zbockaj/GarageNotifier-PCB/README.md

# GarageNotifier-PCB
Helium-network device for reporting open/closed status of (garage) door.
