zbockaj/GarageNotifier-PCB/GarageNotifier.kicad_pcb

## KiCad design GarageNotifier.kicad_pcb (2022-08-15)

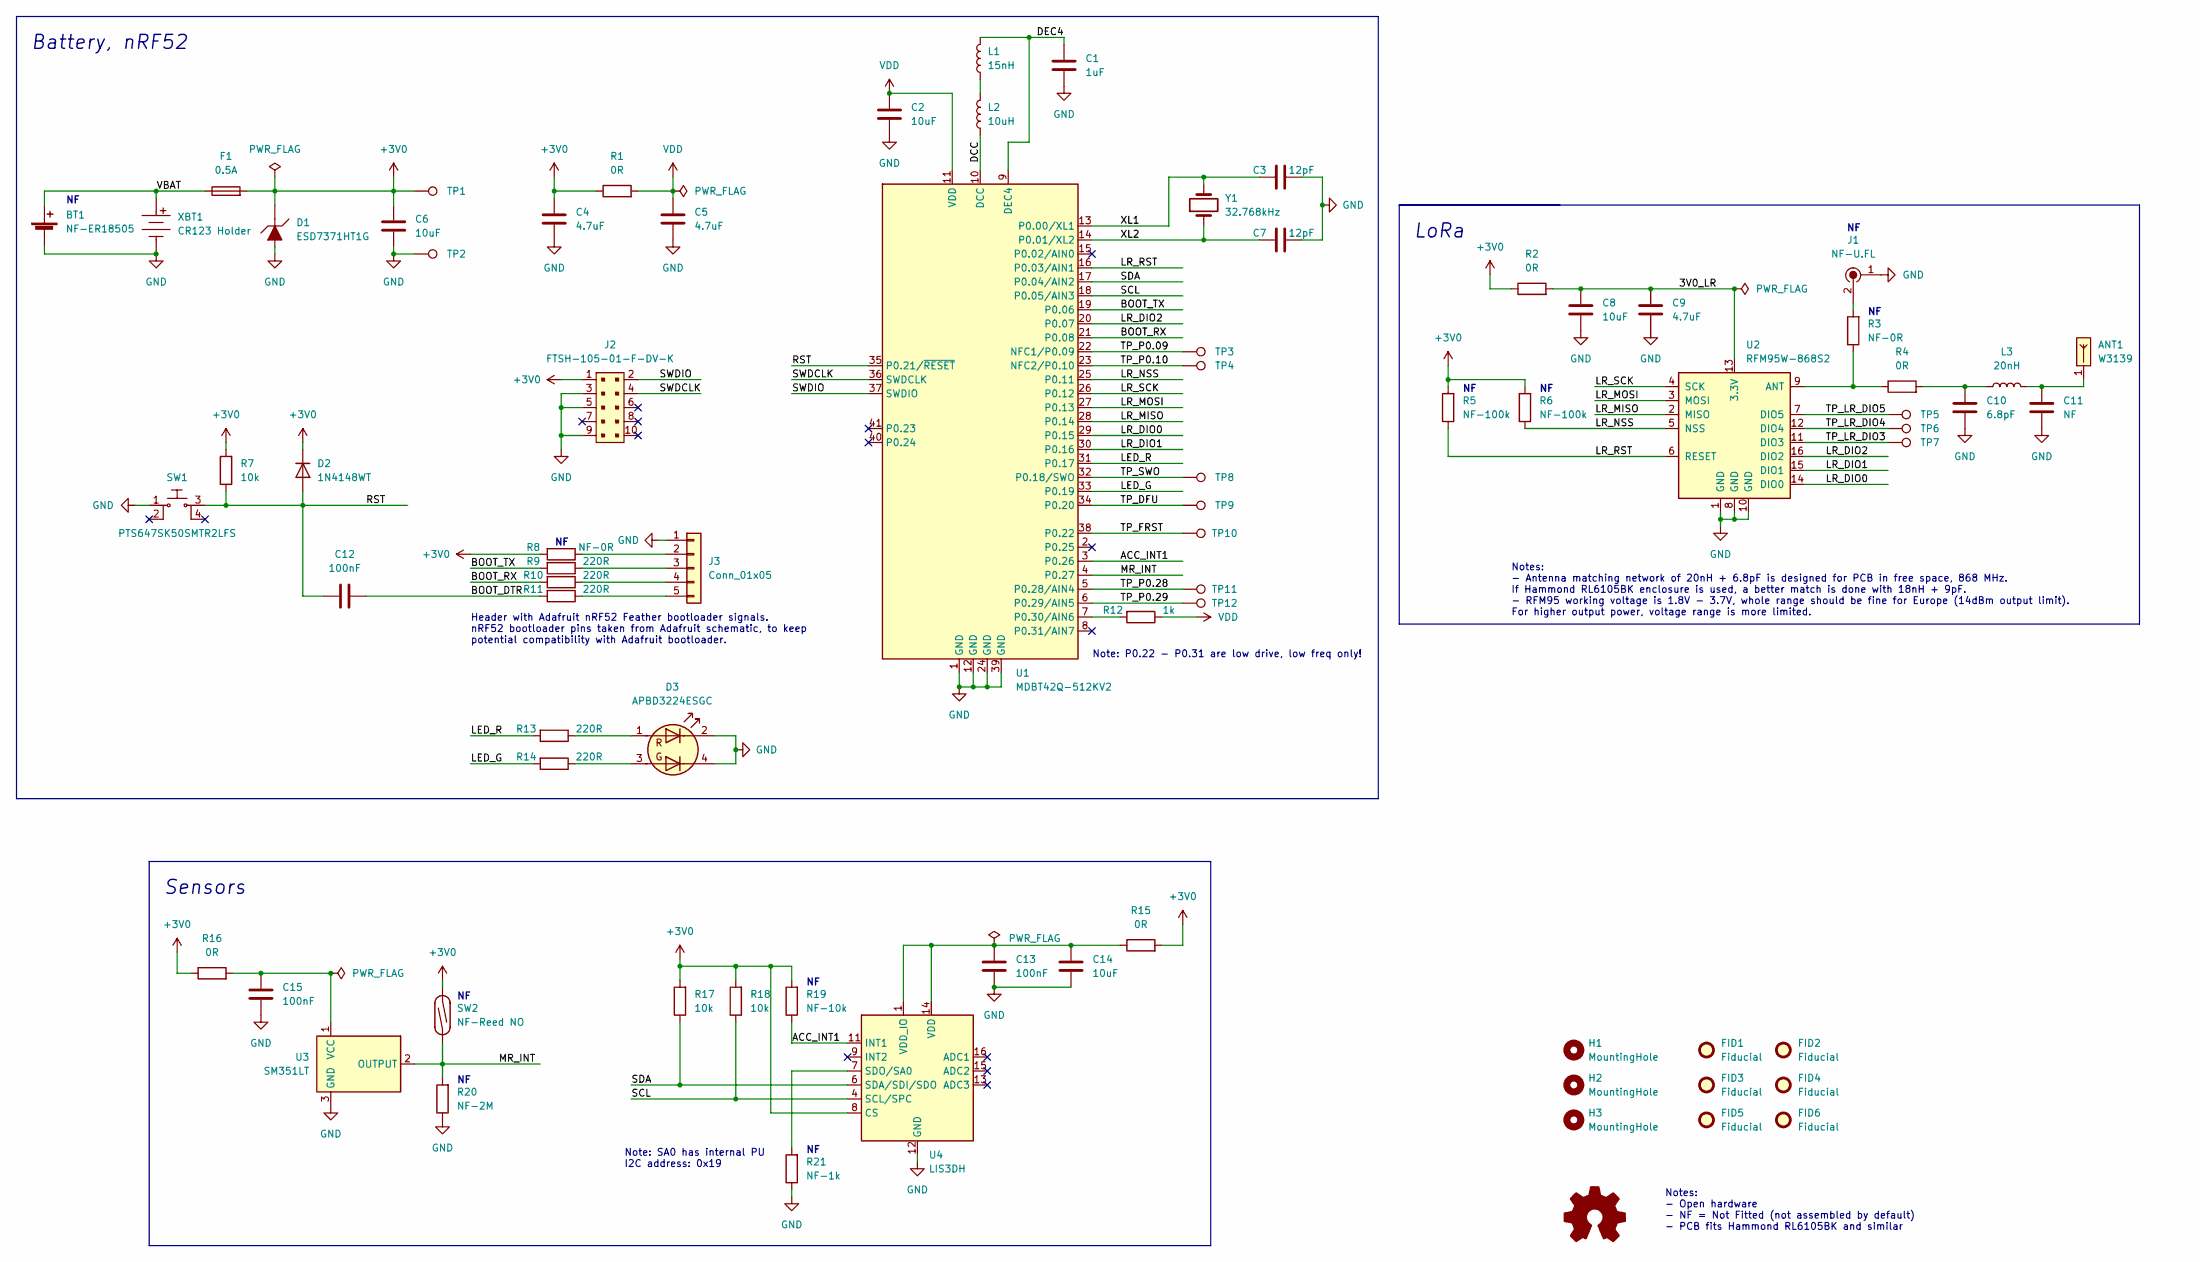
[picture p1: schematic GarageNotifier.kicad_sch]

Parts:
ANT1: W3139; MPN W3139
BT1: NF-ER18505; ER18505; MPN ER18505
C1: 1uF; C_0402_1005Metric
C2, C6, C8, C14: 10uF; C_0603_1608Metric
C3, C7: 12pF; C_0402_1005Metric
C4, C5, C9: 4.7uF; C_0603_1608Metric
C10: 6.8pF; C_0603_1608Metric
C11: NF; C_0603_1608Metric
C12, C13, C15: 100nF; C_0603_1608Metric
D1: ESD7371HT1G; SOD-323; MPN ESD7371HT1G
D2: 1N4148WT; D_SOD-523; MPN 1N4148WT
D3: APBD3224ESGC; LED_Kingbright_APBD3224; MPN APBD3224ESGC-F01
F1: 0.5A; R_0603_1608Metric; MPN 0467.500NRHF
FID1, FID2, FID3, FID4, FID5, FID6: Fiducial; Fiducial_1mm_Mask2mm
H1, H2, H3: MountingHole; MountingHole_2.7mm_M2.5_ISO7380
J1: NF-U.FL; Coax_Conn_U.FL; MPN U.FL-R-SMT-1(10); Digi-Key_PN H11891CT-ND
J2: FTSH-105-01-F-DV-K; PinHeader_2x5_P1.27_SMD; MPN FTSH-105-01-F-DV-K; Digi-Key_PN SAM8796-ND
J3: Conn_01x05; PinHeader_1x05_P2.54mm_Vertical
L1: 15nH; L_0402_1005Metric; MPN LQG15HS15NJ02D
L2: 10uH; L_0603_1608Metric; MPN LQM18FN100M00D
L3: 20nH; L_0603_1608Metric; MPN LQW18AN20NG00D
R1, R2, R4, R15, R16: 0R; R_0603_1608Metric
R3, R8: NF-0R; R_0603_1608Metric
R5, R6: NF-100k; R_0603_1608Metric
R7, R17, R18: 10k; R_0603_1608Metric
R9, R10, R11, R13, R14: 220R; R_0603_1608Metric
R12: 1k; R_0603_1608Metric
R19: NF-10k; R_0603_1608Metric
R20: NF-2M; R_0603_1608Metric
R21: NF-1k; R_0603_1608Metric
SW1: PTS647SK50SMTR2LFS; MPN PTS647SK50SMTR2LFS
SW2: NF-Reed NO; MK15-B-2_Reed; MPN MK15-B-2
TP1, TP2, TP3, TP4, TP5, TP6, TP7, TP8, TP9, TP10, TP11, TP12: TestPoint; TestPoint_Pad_D1.5mm
U1: MDBT42Q-512KV2; MPN MDBT42Q-512KV2
U2: RFM95W-868S2; HOPERF_RFM9XW_SMD; MPN 109990166
U3: SM351LT; SOT-23; MPN SM351LT
U4: LIS3DH; ST_LGA-16_3x3mm; MPN LIS3DHTR
XBT1: CR123 Holder; Keystone_1051; MPN 1051
Y1: 32.768kHz; Crystal_SMD_3215-2Pin_3.2x1.5mm; MPN FC-135 32.7680KA-AC

Connections:
+3V0: C4.1, C6.1, D1.1 (A1), D2.1 (K), F1.2, J2.1, R1.1, R2.1, R5.2, R6.2, R7.2, R8.2, R15.2, R16.1, R17.2, R18.2, R19.2, SW2.2, TP1.1, U4.8 (CS)
/3V0_LR: C8.1, C9.1, R2.2, U2.13 (3.3V)
/ACC_INT1: R19.1, U1.3 (P0.26), U4.11 (INT1)
/BOOT_DTR: C12.1, R11.2
/BOOT_RX: R10.2, U1.21 (P0.08)
/BOOT_TX: R9.2, U1.19 (P0.06)
/DCC: L2.1, U1.10 (DCC)
/DEC4: C1.1, L1.2, U1.9 (DEC4)
/LED_G: R14.2, U1.33 (P0.19)
/LED_R: R13.2, U1.31 (P0.17)
/LR_DIO0: U1.29 (P0.15), U2.14 (DIO0)
/LR_DIO1: U1.30 (P0.16), U2.15 (DIO1)
/LR_DIO2: U1.20 (P0.07), U2.16 (DIO2)
/LR_MISO: U1.28 (P0.14), U2.2 (MISO)
/LR_MOSI: U1.27 (P0.13), U2.3 (MOSI)
/LR_NSS: R6.1, U1.25 (P0.11), U2.5 (NSS)
/LR_RST: R5.1, U1.16 (P0.03/AIN1), U2.6 (RESET)
/LR_SCK: U1.26 (P0.12), U2.4 (SCK)
/MR_INT: R20.2, SW2.1, U1.4 (P0.27), U3.2 (OUTPUT)
/RST: C12.2, D2.2 (A), R7.1, SW1.3, U1.35 (P0.21/~RESET)
/SCL: R18.1, U1.18 (P0.05/AIN3), U4.4 (SCL/SPC)
/SDA: R17.1, U1.17 (P0.04/AIN2), U4.6 (SDA/SDI/SDO)
/SWDCLK: J2.4, U1.36 (SWDCLK)
/SWDIO: J2.2, U1.37 (SWDIO)
/TP_DFU: TP9.1, U1.34 (P0.20)
/TP_FRST: TP10.1, U1.38 (P0.22)
/TP_LR_DIO3: TP7.1, U2.11 (DIO3)
/TP_LR_DIO4: TP6.1, U2.12 (DIO4)
/TP_LR_DIO5: TP5.1, U2.7 (DIO5)
/TP_P0.09: TP3.1, U1.22 (NFC1/P0.09)
/TP_P0.10: TP4.1, U1.23 (NFC2/P0.10)
/TP_P0.28: TP11.1, U1.5 (P0.28/AIN4)
/TP_P0.29: TP12.1, U1.6 (P0.29/AIN5)
/TP_SWO: TP8.1, U1.32 (P0.18/SWO)
/VBAT: BT1.1 (+), F1.1, XBT1.1
/XL1: C3.1, U1.13 (P0.00/XL1), Y1.2
/XL2: C7.1, U1.14 (P0.01/XL2), Y1.1
GND: BT1.2 (-), C1.2, C2.2, C3.2, C4.2, C5.2, C6.2, C7.2, C8.2, C9.2, C10.1, C11.1, C13.2, C14.2, C15.2, D1.2 (A2), D3.2 (K1), D3.4 (K2), J1.1, J2.3, J2.5, J2.9, J3.1, R20.1, R21.1, SW1.1, TP2.1, U1.1 (GND), U1.12 (GND), U1.24 (GND), U1.39 (GND), U2.1 (GND), U2.8 (GND), U2.10 (GND), U3.3 (GND), U4.5 (GND), U4.10 (GND), U4.12 (GND), XBT1.2
unnamed: ANT1.1 (FP), C11.2, L3.2
unnamed: C10.2, L3.1, R4.2
unnamed: C13.1, C14.1, R15.1, U4.1 (VDD_IO), U4.14 (VDD)
unnamed: C15.1, R16.2, U3.1 (VCC)
unnamed: D3.1 (A1), R13.1
unnamed: D3.3 (A2), R14.1
unnamed: J1.2, R3.2
unnamed: J3.2, R8.1
unnamed: J3.3, R9.1
unnamed: J3.4, R10.1
unnamed: J3.5, R11.1
unnamed: L1.1, L2.2
unnamed: R3.1, R4.1, U2.9 (ANT)
unnamed: R12.2, U1.7 (P0.30/AIN6)
unnamed: R21.2, U4.7 (SDO/SA0)
VDD: C2.1, C5.1, R1.2, R12.1, U1.11 (VDD)

Notes on the sheet:
Notes: - Antenna matching network of 20nH + 6.8pF is designed for PCB in free space, 868 MHz. If Hammond RL6105BK enclosure is used, a better match is done with 18nH + 9pF. - RFM95 working voltage is 1.8V - 3.7V, whole range should be fine for Europe (14dBm output limit). For higher output power, v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
Note: P0.22 - P0.31 are low drive, low freq only!
Notes: - Open hardware - NF = Not Fitted (not assembled by default) - PCB fits Hammond RL6105BK and similar
Sensors
Battery, nRF52
Header with Adafruit nRF52 Feather bootloader signals. nRF52 bootloader pins taken from Adafruit schematic, to keep potential compatibility with Adafruit bootloader.
Note: SA0 has internal PU I2C address: 0x19
LoRa

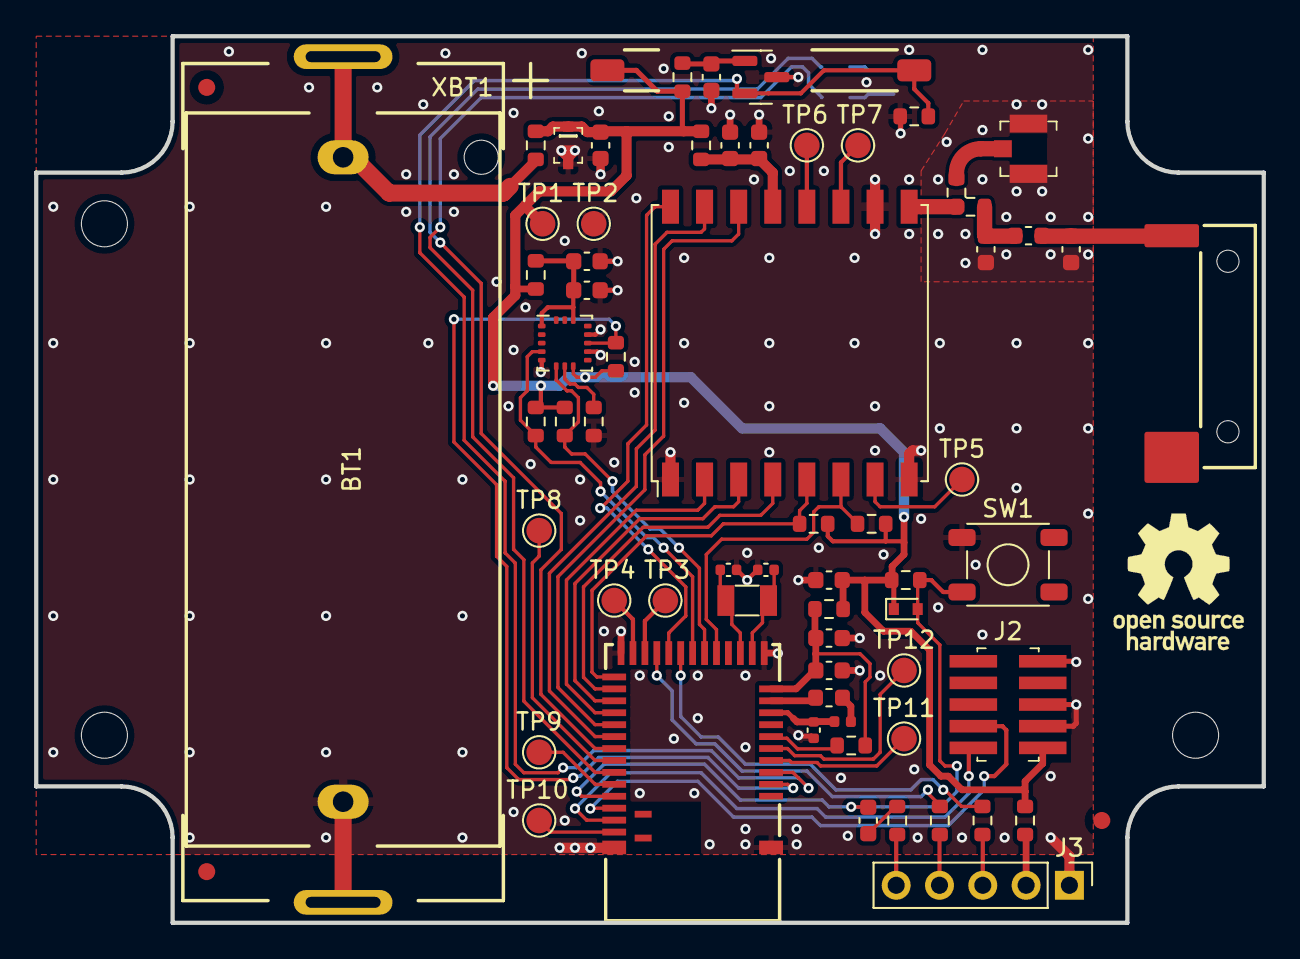
[picture p2: board GarageNotifier.kicad_pcb from above]

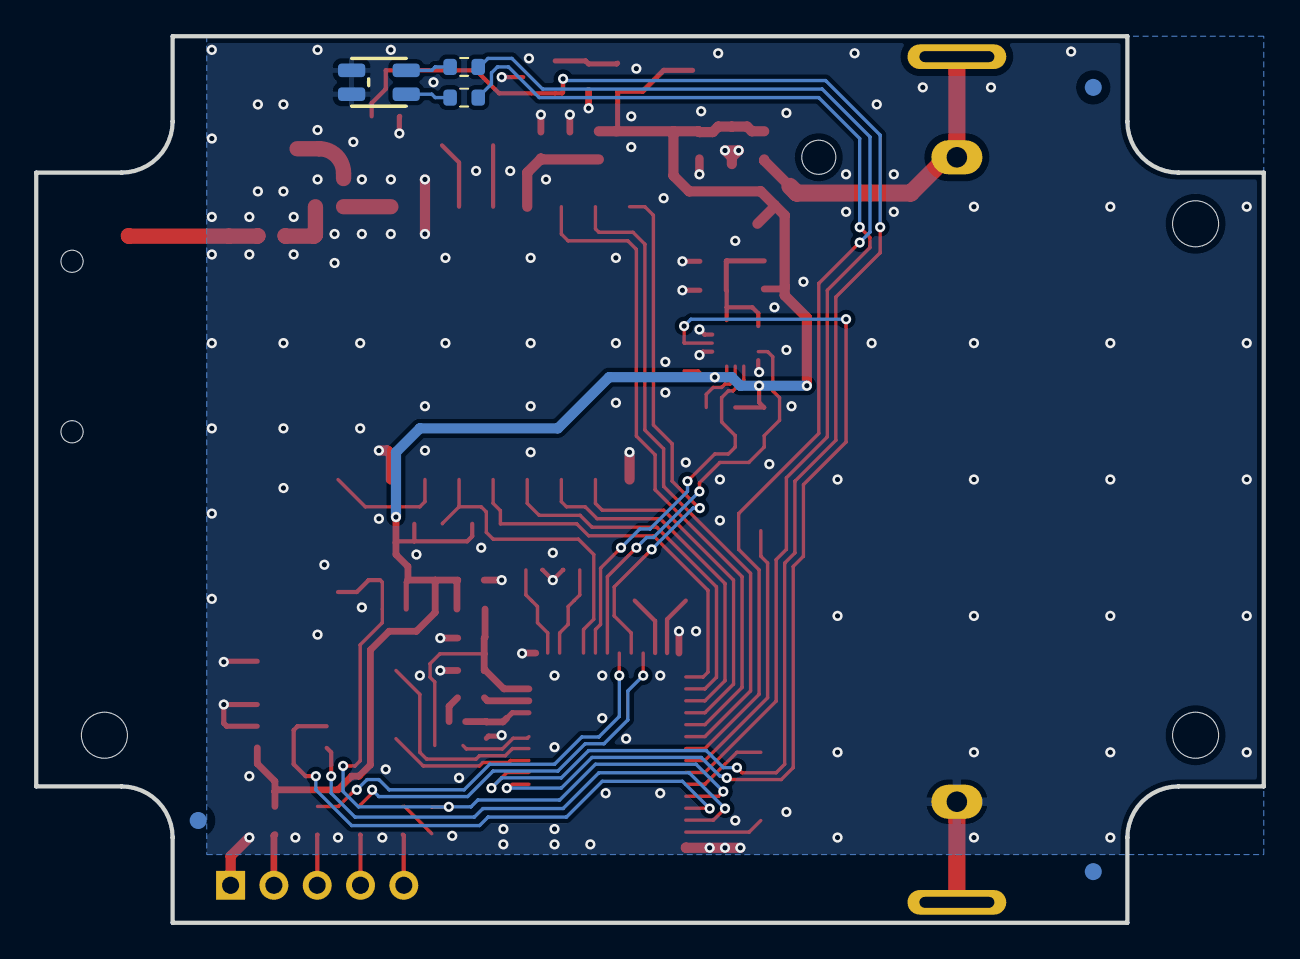
[picture p3: board GarageNotifier.kicad_pcb from below]

Board: 2 copper layers, 72.0 x 52.0 mm, 77 parts (6 on the bottom side), 54 nets.
