zbockaj/GarageNotifier-PCB/(commit log)

2022-08-15 KiCad files added
    [GarageNotifier.kicad_pcb, GarageNotifier.kicad_sch]
2022-08-15 Added release files
    Added zip files with PCB production and assembling info used for JLCPCB. Removed digikey project library (now it is kicad global).
    [GarageNotifier.kicad_pcb, GarageNotifier.kicad_sch]
